omer182/padi/desktop/src-tauri/resources/packs/licenses/Crystal FX/README.txt

Synth Crystal
-------------

Version 2019-08-12

General MIDI instrument #99: Synth FX 3 (crystal).

Samples by Strix SoundFont Team <dsoundfont123@gmail.com>, sent to the FreePats project on November 2018. Recorded from Dexed software synthesizer.

Please visit FreePats web pages for updates and more content:
http://freepats.zenvoid.org/

Published under the terms of Creative Commons CC0 public domain dedication:
https://creativecommons.org/publicdomain/zero/1.0/
