omer182/padi/desktop/src-tauri/resources/packs/CREDITS.md

# Sound packs

Extra SoundFont banks loaded next to GeneralUser GS. All come from the
FreePats project (https://freepats.zenvoid.org). Each pack's original README
and license text is in `licenses/<pack name>/`.

| Pack | Source release | License |
|---|---|---|
| Spanish Guitar | SpanishClassicalGuitar-SF2-20190618 | CC0 1.0 |
| Steel String Guitar | FSS-SteelStringGuitar-SF2-20200521 | GPL-3.0+ with the FreePats exception (source: SFZ/WAV at freepats.zenvoid.org/Guitar) |
| Electric Guitar Clean | EGuitarFSBS-clean-bridge-small-SF2-20260807 | CC0 1.0 |
| Grand Piano YDP | YDP-GrandPiano-SF2-20160804 | CC BY 3.0 (see attribution below) |
| FM Electric Piano | FM-Piano1-SF2-20190916 | CC0 1.0 |
| SciFi FX | SynthSciFi-SF2-20200517 | CC0 1.0 |
| Goblins FX | SynthGoblins-SF2-20200612 | CC0 1.0 |
| Soundtrack FX | SynthSoundtrack-SF2-20200521 | CC0 1.0 |
| Crystal FX | SynthCrystal-SF2-20190812 | CC0 1.0 |

## Attribution (CC BY 3.0)

Grand Piano YDP: soundfont and sample modifications by roberto@zenvoid.org for
FreePats, built from the Zenph Studios Yamaha Disklavier Pro Piano Multisamples
for OLPC (Dr. Mikhail Krishtal and team, Zenph Studios), from the OLPC sound
sample library curated by Dr. Richard Boulanger. License:
https://creativecommons.org/licenses/by/3.0/

The .sf2 files are not in git (the piano is over GitHub's 100 MB limit).
Run `scripts/get-packs.sh` to download them again.
