omer182/padi/docs/images/macropad.webp

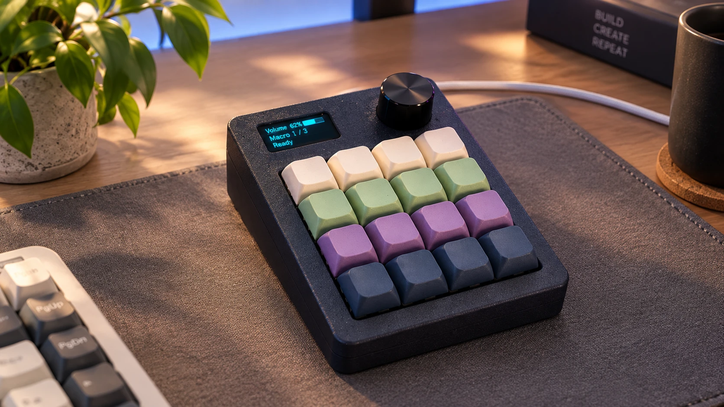
docs/images/macropad.webp
