omer182/padi/hardware/case/Key_Plate.stl

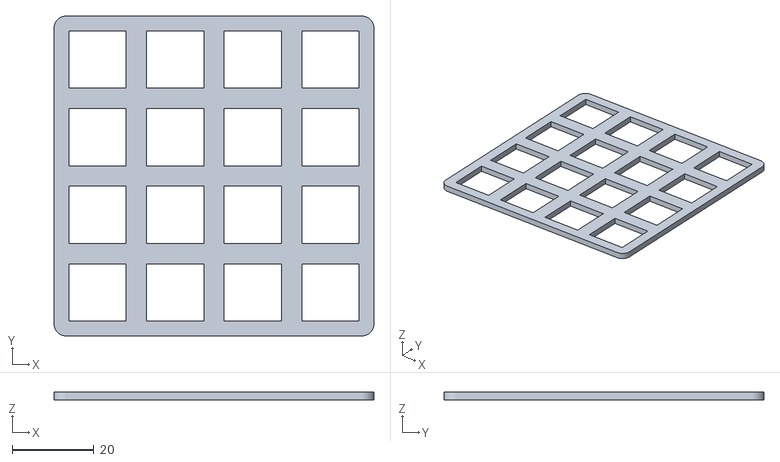
[picture p8: CAD file, 2026-10-25]
hardware/case/Key_Plate.stl
78.4 x 78.4 x 2.00
