omer182/padi/hardware/case/Top_Shell.stl

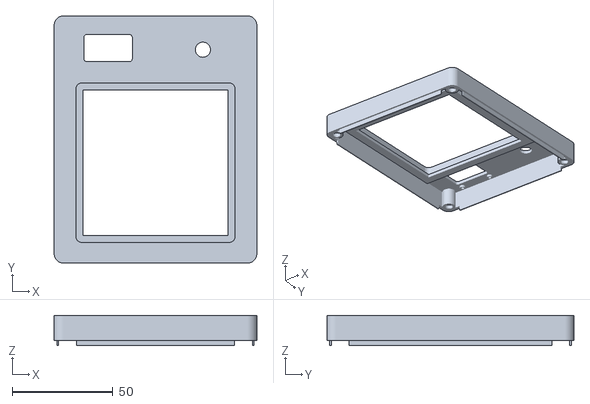
[picture p9: CAD file, 2026-10-25]
hardware/case/Top_Shell.stl
100.4 x 122.4 x 15.0
