omer182/padi/hardware/case/Base_Shell.stl

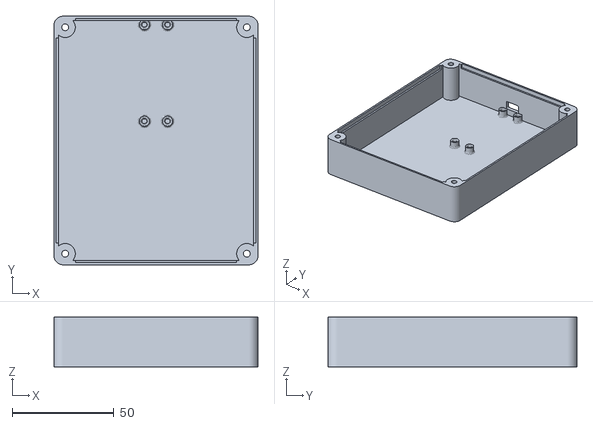
[picture p10: CAD file, 2026-10-25]
hardware/case/Base_Shell.stl
100.4 x 122.4 x 24.5
