omer182/padi/(commit log)

2026-07-06 DJ features: tap tempo + BPM sync, hold-to-activate FX pads
    - Global BPM (tap tempo on Beats page pad 9, +/- on 10/11); all beats run
    off it and it's shown on the Beats page + main screen
    - Top row = hold-to-activate FX: GP12 Filter, GP13 Tape-stop,
    GP14 Echo throw, GP15 Stutter (BPM-synced gate); bottom 12 pads = notes
    - clearFX() on menu open; removed stale preset-save hold logic
2026-07-06 Revert DJ FX pads + tap tempo: restore all 16 play keys
    Removed the top-row hold-FX (filter/tape-stop/echo/stutter) and tap-tempo
    per user preference. Back to 16 note pads + beats + instruments + scales/
    chords + volume. (DJ features remain in history at 4c030b2 if wanted later.)
2026-07-06 Surge catalog: 6 categories x 8 curated patches, browsable in menu
    Device sends Bank Select (CC0=category) + Program Change (patch); bridge
    loads the matching .fxp via OSC. Keys leads with acoustic Grand Piano
    (boot default). Menu page 1 browses Keys/Pads/Leads/Bass/Plucks/Poly.
2026-07-07 Volume: trimmed-mean oversampling to kill idle ADC jitter (RP2040-E11 DNL)
    Median-of-9 couldn't suppress the ADC's stationary code-toggle; a trimmed
    mean of 25 samples (drop 6 each end, average middle 13) averages it out.
2026-07-07 Volume: reject large unconfirmed jumps (loose-wire/open-circuit blips)
    A >=12-step swing must hold for 6 reads (~120ms) before it's trusted, so a
    momentary open on the pot wiper no longer slams the volume to a rail.
2026-07-07 Volume: replace hold-to-confirm guard with slew limiting (smooth turns)
    The confirm guard stalled fast turns until the reading settled, causing a
    pause+lurch. Slew limiting chases the target ~7 steps/cycle: turns track
    smoothly and glitches can only nudge it a little instead of slamming a rail.
2026-07-07 Volume: auto-calibrate pot range (fixes max reading only ~50%)
    Hardcoded POT_RAW_MIN/MAX 200/900 didn't match the pot's real span, so the
    loud end mapped to mid-scale. Now learn calLo/calHi from observed readings
    (ignoring rail glitches); ends always hit 0/100 after one full sweep.
2026-07-07 Volume: pin calibration to measured pot range (433-1022), remove diagnostic Catalog: +4 categories of standout Surge sounds (Arps/Space/SynBass/Signat)
    Volume now uses fixed clamps (POT_RAW_MIN/MAX 510/1000) matching this pot's
    real span so both ends lock to 0/100 despite its flaky loud-end joint.
    Catalog grows 6->10 categories (48->80 sounds), adding factory Sequences +
    3rd-party gems from Luna, Nick Moritz, Vincent Zauhar, Argitoth, Rare Earth,
    Databroth. Bridge CATALOG paths kept in lockstep with catalog.h.
2026-07-07 Volume: stop OLED-redraw noise from moving volume while playing
    Skip pot ADC sampling for 30ms after each redraw (I2C burst couples into
    GP26), throttle redraws 40->70ms, widen deadband 3->4.
2026-07-07 Instrument: persist last-selected patch across reboots/reconnects
    FlashData gains lastCat/lastPatch (magic bumped); selectInstrument saves them
    quietly (no LED), boot restores them instead of forcing Grand Piano. Falls
    back to Keys/Grand Piano only when nothing saved yet.
2026-07-07 Volume: rest-latch so only a real knob turn changes it (kills play jitter)
    Volume now ignores any reading within the noise floor of its settled rest
    point; it engages only when the knob moves past ~18 raw counts, tracks
    smoothly, then re-latches on stop. Playing notes/chords/beats no longer
    wobbles the volume.
2026-07-07 Volume: adaptive auto-cal + self-heal for drifting pot (non-repeatable joint)
    Fixed calibration can't track a pot whose max reading drifts 433->642 at the
    same position. Auto-cal learns the current range (sweep once), self-heals via
    slow decay, clamps ends with a margin, keeps the rest-latch anti-jitter.
    Root cause is a failing pot connection; software now adapts as best it can.
2026-07-07 Knob FX: repurpose knob from volume to a selectable MIDI effect (portable)
    Knob now sends standard MIDI (CC74/71/91/93/85/86/87 or pitch bend) so it
    stays plug-and-play on any Mac/PC/synth; volume is set on the host. New
    "KNOB FX" menu page 5 picks from 8 effects (Filter/Reso/Pitch/Reverb/Chorus/
    Delay/Phaser/Drive) and previews the choice on the current instrument.
    Selection persisted in flash. Bridge translates each CC to Surge: native
    filter/reso + scene-A insert-slot retyping for the time-based FX (types
    discovered via OSC probe). Main screen shows the FX + amount instead of vol.
2026-07-07 Knob FX: drop auto-cal/decay (caused idle jitter); simple fixed map + latch
    The self-heal decay kept shifting the mapping every 80ms and forced constant
    output near the ends -> FX jittered untouched. Replaced with a fixed 0..127
    map + rest-latch (idle unless a real >10-unit move). Bridge keeps Surge at
    full master volume on startup + patch load (knob no longer sets volume).
2026-10-24 Add PADI desktop app (Tauri 2 + React) with built-in sound engine
    - Tray app that replaces the Python bridge/supervisor + Surge: finds the
    pad (MIDI + COM3 serial), reconnects on replug, single instance,
    optional start-at-login.
    - Built-in SoundFont engine (rustysynth + cpal) with GeneralUser GS
    (287 presets incl. 13 drum kits); follows the default audio output.
    - Live view: 4x4 pad grid with per-mode labels, pad menu mirror, knob
    meter, keyboard, activity log; click pads on screen to play.
    - Picking a drum kit switches the pad into Drums mode (and back).
    - Firmware: pad/state telemetry over USB serial plus a host "st <n>"
    command to set the play style.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
2026-10-24 PADI: sampler, looper, sound editor, sound packs, right-click menus
    - Mic recording onto pads (auto-trim/normalize), saved kits with
    undo/redo (Ctrl+Z / Ctrl+Y), copy/spread/clear, duplicate/delete kits.
    - Per-pad play mode (one-shot/hold/loop), echo send, Robot and Lo-fi
    voices, pitch, reverse; record mode turns off after each take.
    - Looper: count-in, overdub layers, mute/solo/delete, undo/redo,
    export loop WAV, record whole session to Music\PADI.
    - Sound editor for stock sounds (reverb, echo, chorus, brightness,
    octave, volume, pan); saving makes a copy under My sounds.
    - Engine plays several SoundFonts at once; FreePats packs (guitars,
    grand/FM piano, sci-fi FX) load from resou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
2026-10-25 Repo for publishing: README, wiring diagram, case STLs, app icon
    - New README: what PADI is, parts list, printing, wiring, assembly,
    flashing (UF2), installing the app, how to play, building from source.
    - hardware/: case STLs (Base_Shell, Top_Shell, Key_Plate) and a
    generated wiring diagram (make_wiring.py -> wiring.svg).
    - Firmware moved to firmware/macropad-midi; old Python bridge and the
    original tactile-switch STL removed (replaced by the app and new case).
    - PADI app icon; NSIS installer metadata.
    - Sounds tab: one "Extra sounds" tag groups all downloaded packs.
    - LICENSE: add copyright line next to Nick Culbertson's.
2026-10-31 README: app section with demo GIF and screenshots; UI demo mode
    - desktop/src/demo.ts: when the UI runs in a plain browser (no Tauri
    backend), mock the backend with sample data so it can be explored and
    captured. Scenes: ?scene=main | sampler | armed. Not loaded in the app.
    - README "The app" section: animated demo + four screenshots
    (play, sample, record, right-click menu).
    - Fix: pad tags no longer cover the pad number (one row, loop shown as
    an icon, "bot" for Robot); muted loop layers stay readable.
2026-10-31 Demo video: 808 trap version showing more features
    20.6 s, 140 BPM, A minor:
    - Saw Lead riff with the pad knob opening the filter, looper recording L1
    - 808/909 kit + synthesized gliding 808 sub, overdub L2, echo slider up
    - sampler pads: Robot voice (ring-mod), chipmunk stabs, Hey!, Pop, L3
    - outro with the filter closing; sci-fi risers into each section
    One timeline (scripts/demo-video/timeline.mjs -> timeline.json) drives
    both capture.mjs (UI demo mode frames) and the demo_audio example
    (soundtrack), so picture and sound line up frame-exactly.
